caioluchetti/GreenhouseLucor/(commit log)

2026-06-30 feat: MQTT TLS para ESP32 remoto + passo a passo completo
    - Instala Mosquitto com TLS (porta 8883) + listener local (1883)
    - Certificado auto-assinado para greenhousemqtt.cortada-server.ddns.net
    - Firmware ESP32 principal adaptado para WiFiClientSecure + fingerprint
    - Firmware ESP32-CAM adaptado para MQTT TLS remoto
    - Backend modo real ativado (MQTT_MODE=real)
    - README atualizado com passo a passo de deploy incluindo ESP32-CAM
    - Fingerprint SHA1: 36:12:05:B8:85:08:C1:9B:A0:F0:FA:6B:CC:C2:F2:8B:79:56:23:E7
2026-07-01 feat: MQTT video streaming (ESP32-CAM pushes JPEG frames via MQTT, backend serves MJPEG)
2026-07-01 fix: ESP32 core 3.x compatibility (setFingerprint→setInsecure, WebServer::on signature)
    [greenhouse_cam_esp32cam.ino]
2026-07-01 feat: replace MQTT camera transport with HTTPS POST (esp32-cam uploads JPEG directly to /api/camera/frame)
    [greenhouse_cam_esp32cam.ino]
2026-07-01 fix: add NTP time sync and DNS debug (TLS requires valid system clock)
    [greenhouse_cam_esp32cam.ino]
2026-07-01 debug: add Serial prints to uploadFrame (heap, HTTP status, timeout)
2026-07-01 fix: parse HTTP response line as string instead of parseInt
    [greenhouse_cam_esp32cam.ino]
2026-07-01 fix: explicit SNI + print/println HTTP (502 on NPM caused by missing SNI/printf issues)
    [greenhouse_cam_esp32cam.ino]
2026-07-01 fix: remove setSSL/setServername (not available in ESP32 core 3.x)
    [greenhouse_cam_esp32cam.ino]
2026-07-01 fix: show Desligar button when zone is manually ON (no irrigation timer needed)
2026-07-01 docs: finalize Spider Cam + Timelapse architecture (P4 vision-only, ESP32 direct to gantry, TFLite specs, MQTT topics)
2026-07-01 refactor: reorganize dashboard layout — camera + sensors top row, zones promoted
    - Desktop: 2-col top row (camera 60% + sensors 40%), zone cards moved
    below so primary controls are visible without scrolling
    - Mobile: controls-first ordering (zones -> camera -> sensors) via
    Tailwind order- utilities
    - SensorPanel: stacks vertically in narrow desktop column, stretches
    to match camera height (h-full, lg:grid-cols-1)
    - CameraFeed: h-full flex wrappers so the card fills its grid cell and
    avoids layout shift on connect/disconnect
2026-07-03 feat: add LCD 16x2 I2C display to ESP32 firmware + update docs for 8-channel relay module
    - Add LiquidCrystal_I2C library, 3-page rotation (sensors/zones/connectivity)
    - Non-blocking LCD refresh (500ms) with page switch every 3s
    - Boot screen on startup, live zone refresh on setRelay()
    - I2C pins: GPIO 21 (SDA), GPIO 22 (SCL), address 0x27
    - Update README: 8ch relay replaces 4ch+2ch, LCD in BOM/pinout/wiring/power
    - Update AGENTS.md: hardware line, pin list, library list
    [greenhouse_lucor_esp32.ino]
2026-07-03 feat: update TLS fingerprint for local Mosquitto via WireGuard
    - New self-signed cert (CN=greenhousemqtt.cortada-server.ddns.net)
    - Broker runs on local machine, Oracle VM forwards 8883 via WireGuard DNAT
    - Fingerprint: 55:3C:48:09:40:6C:C9:04:59:68:F0:C4:C4:CD:D9:96:23:E6:F7:74
    [greenhouse_lucor_esp32.ino]
2026-07-03 Add ESP32 firmware for greenhouse camera and irrigation control
    - Implement greenhouse camera firmware (greenhouse_cam_esp32cam.ino) for capturing and streaming images via HTTP and uploading frames to a backend server.
    - Introduce autonomous irrigation control firmware (greenhouse_lucor_esp32.ino) with scheduling, climate monitoring, and MQTT integration.
    - Include support for DHT sensors, relay control for irrigation zones, and LCD display for status updates.
    - Establish NTP time synchronization and local schedule management with non-volatile storage.
2026-07-11 Feat: many updates - Relays, DHT22
2026-07-11 Feat: OTA ESP32CAM and more frames
2026-07-11 FIX: Server.py and ADDED Build files
    [partitions.csv]
2026-07-12 Feat: Build greenhouse_lucor_esp32 firmware with PlatformIO
    - Add platformio.ini (esp32dev, ArduinoJson v6, WiFiManager, default.csv OTA partitions)
    - Build artifacts in build/esp32.esp32.esp32dev/: .bin, bootloader, partitions, ELF, map, flash_args
    - firmware.bin: 1.06MB, Flash 82.5%, RAM 16.4%
    - .gitignore: ignore PlatformIO .pio/ intermediates
2026-07-12 Feat: Move light toggle to Dashboard as LightCard
    - New LightCard.jsx mirrors ZoneCard visual (amber glow, single toggle button)
    - Dashboard: grid now 2x2 mobile / 1x4 desktop, LightCard next to 3 zones
    - ClimatePanel: light block removed; tab now only has exhaustor + temp thresholds
    - App.jsx: light/onLightToggle props moved from ClimatePanel to Dashboard
2026-07-12 Docs: AGENTS.md — add firmware build/flash/OTA section
    - New 🔩 Firmware ESP32 section: prerequisites, compile (pio run), flash USB (3 methods), OTA via backend API, pin table, libs (platformio.ini), partitions, gotchas
    - Updated file map: LightCard.jsx, platformio.ini, build/ artifact dirs, CAM firmware, nginx client_max_body_size
    - Removed redundant/stale bibliotecas list and pin list (now consolidated in firmware section; old pin values were stale vs actual #define in .ino)
    - Documented known bug: Wi-Fi not persisting across reboots (setSaveConfigCallback + NVS wifi namespace missing)
2026-07-12 Fix: FirmwarePanel device selector stuck when other device OTA busy
    - fetchStatus useCallback had stale closure: was not in deps array,
    so switching the dropdown never re-fetched status for the new device.
    - Combined with greenhouse OTA stuck at 'starting' (never published ok/failed),
    this made isBusy=true permanently, disabling the select for BOTH devices.
    - Fix: add to useCallback deps; existing useEffect re-runs on change.
    - Also fix redeploy regex: only matched tatufa_v*.bin, now also camera_v* / greenhouse_v*
    Operational fix: docker restart greenhouse-backend to clear stuck 'starting'.
2026-07-12 Docs: Save experimental SVGA firmware as reference (not for OTA)
    Experimental build with SVGA 800x600 + JPEG quality 5 + full sensor tuning
    (AWB, AEC, AGC, gain ceiling 8X, lens correction, gamma, BPC/WPC,
    sharpness=1, denoise=0).
    WARNING: caused OTA heap exhaustion when deployed remotely — the
    1.1MB binary download over TLS exhausted RAM (camera + WiFi + MQTT
    all active). Flash via USB only, after heap optimization.
    The main greenhouse_cam_esp32cam.ino remains v1.1.0 (functional).
    [greenhouse_cam_esp32cam_svga.ino]
2026-07-12 Feat: Proxy camera stream via backend (bypass broken TLS to ESP32-CAM)
    The ESP32-CAM can't complete TLS handshakes to the backend (heap exhaustion
    during MQTT/HTTPS connect after OTA crash). Port-forward its local HTTP stream
    (http://tatufa-cam.ddns.net:8085/stream) and proxy it through the backend so
    the HTTPS site can display it without mixed-content blocking.
    - api/server.py: new GET /api/camera/proxy endpoint streams MJPEG from
    CAMERA_STREAM_URL (env override, default tatufa-cam.ddns.net:8085/stream)
    - src/App.jsx: cameraUrl hardcoded to ${API}/camera/proxy (was polling
    /api/camera/status for data.ip, which never arrives since MQTT is down).
    Removed fetchCameraStatus from u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
2026-07-12 Feat: Multi-viewer camera stream via backend fan-out
    The ESP32-CAM WebServer is single-threaded — only one /stream client
    at a time. Previously each browser viewing /api/camera/proxy opened a
    separate connection to the camera, so only 1 person could see the feed.
    Now the backend keeps ONE persistent connection to the camera's /stream
    endpoint (a background thread parses MJPEG frames and stores the latest
    JPEG in _latest_frame). The /api/camera/proxy endpoint fans out that
    single frame to N viewers via multipart/x-mixed-replace — same pattern
    already used by /api/camera/live.
    Architecture:
    ESP32-CAM /stream → 1 background thread → _latest_frame → N browsers
    - New _camera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
2026-07-12 Feat: Switch outside sensor from DHT11 to DHT22
    - DHTTYPE_OUT DHT11 → DHT22 (line 117)
    - FW_VERSION 1.1.0 → 1.2.0
    - Header comment: DHT11 outside → DHT22 outside (GPIO 33)
    - AGENTS.md: pin table, arch line, and gotcha #2 updated
    - Rebuilt .bin (~1.06MB, Flash 82.5%, RAM 16.4%)
2026-07-18 Feat: SHT40 inside sensor, OLED SSD1306 display, authentication system (login/register), CSV export button
2026-07-18 Fix: Separate I2C buses for OLED (Wire1 on GPIO 21/22), non-blocking MQTT reconnect, decouple sensor reads from MQTT
    [greenhouse_lucor_esp32.ino]
2026-07-18 Fix: Remove duplicate Wire1 declaration (predefined by ESP32 core)
    [greenhouse_lucor_esp32.ino]
2026-07-18 Fix: Camera display shows full 800x600 frame (4:3 container + object-contain, no crop)
2026-07-19 Feat: Mirror camera horizontally (scaleX(-1))
2026-08-01 Feat: CSV export of sensor history (backend endpoint + frontend download buttons)
2026-08-14 Add camera scheduling and Google Drive uploads
2026-09-30 Generate GIFs in background jobs with configurable duration
    Queue GIF generation on a worker thread with persisted job status and a
    polling endpoint, let users pick total GIF duration, and write camera
    captures atomically.
